X65/schematic/protoC/protoC.pdf

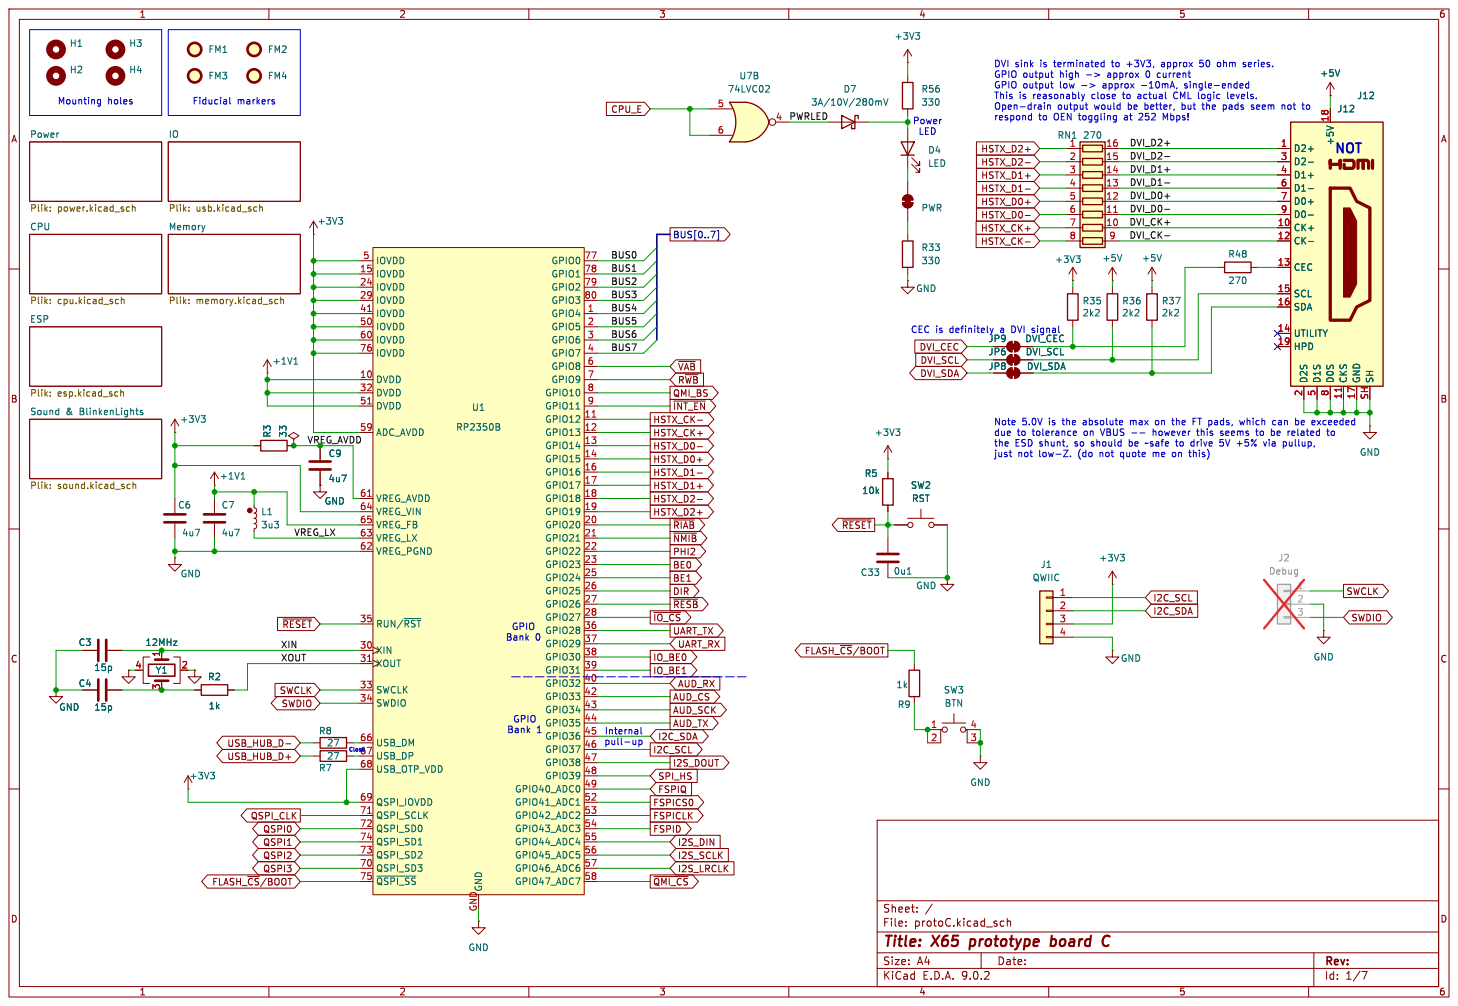
[picture p1: page 1]

J12 D2+ 1 D2- 3 D1+ 4 D1- 6 D0+ 7 D0- 9 CK+ 10 CK- 12 CEC 13 SCL 15 SDA 16 UTILITY 14 HPD 19 D2S

8 CKS 11 GND 17 SH SH

the ESD shunt, so should be ~safe to drive 5V +5% via pullup,
1k SW2 RST

File: protoC.kicad_sch Sheet: /
Id: 1/7 Title: X65 prototype board C

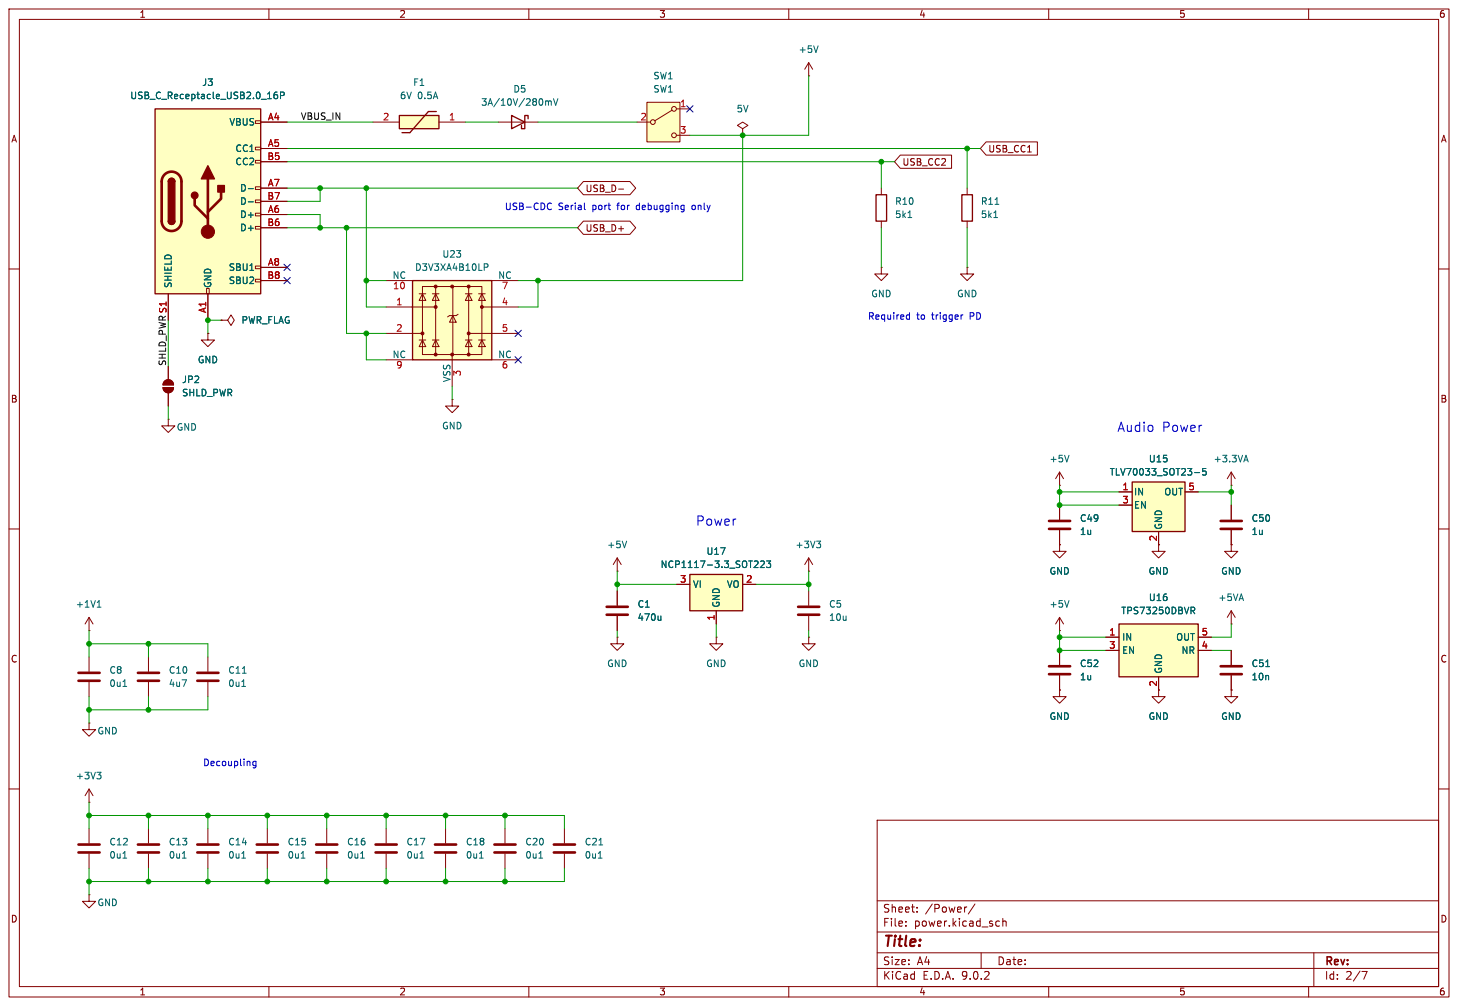
[picture p2: page 2]

Id: 2/7 Title: File: power.kicad_sch Sheet: /Power/

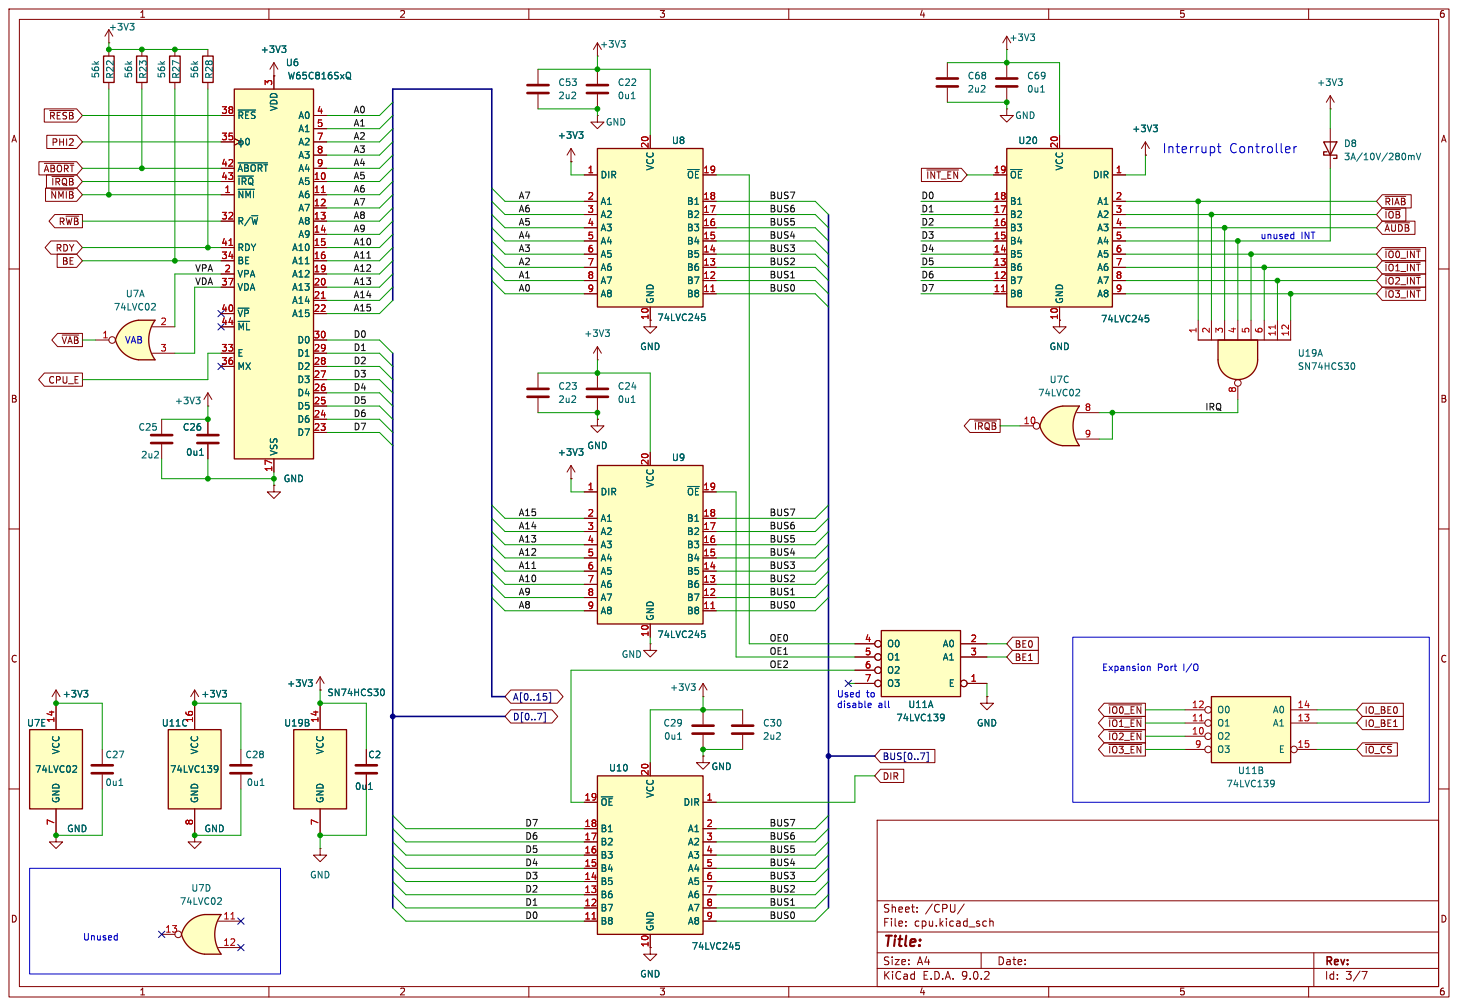
[picture p3: page 3]

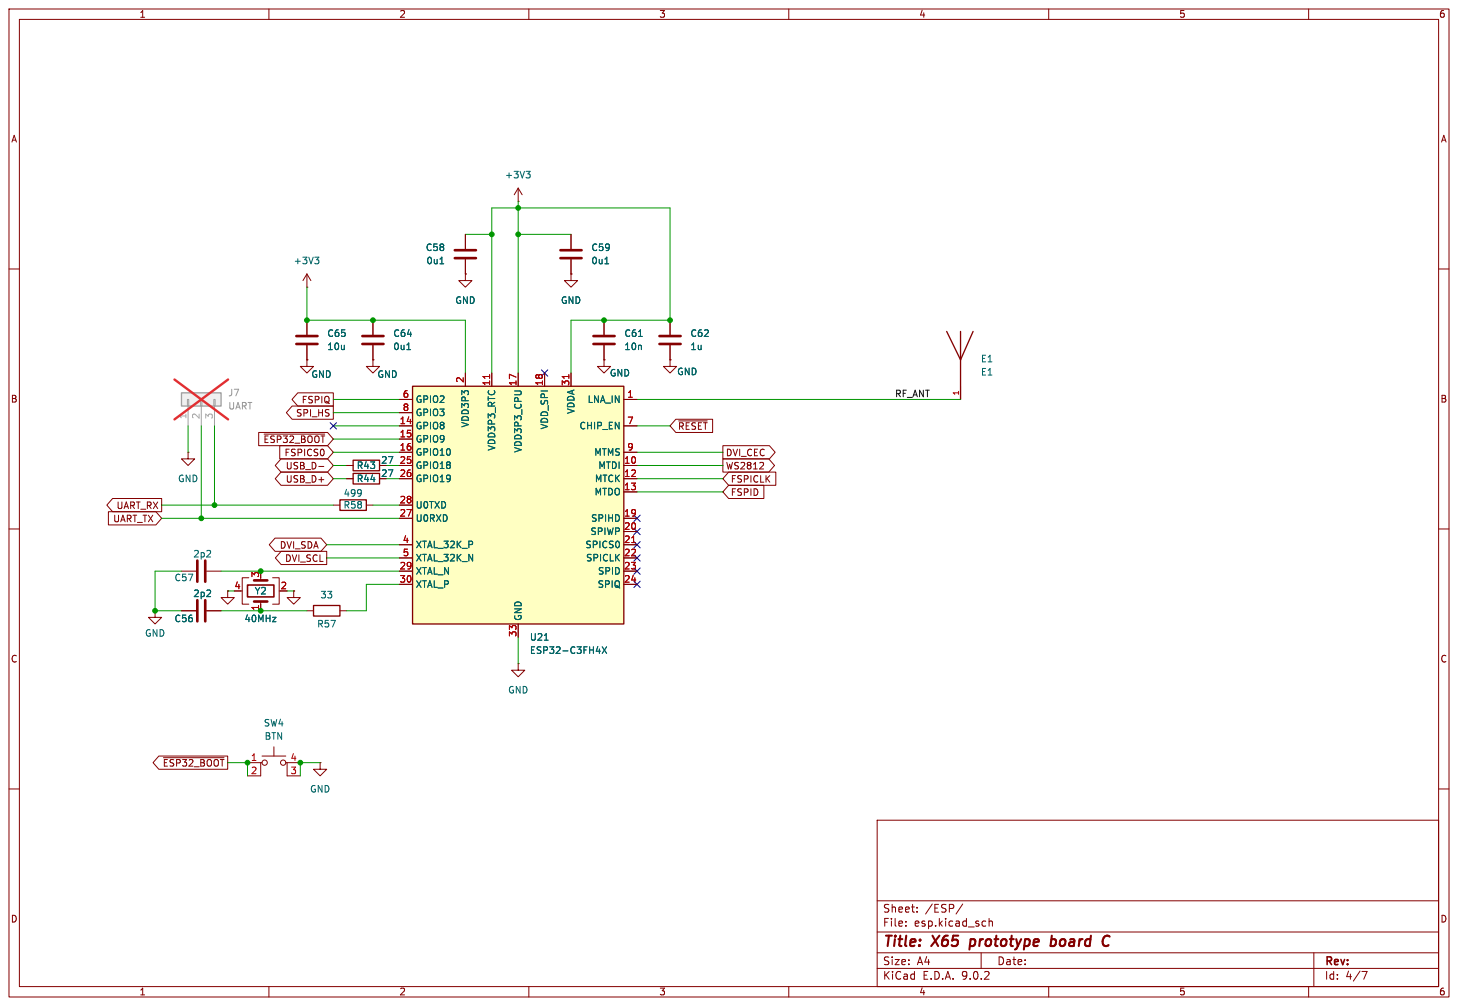
[picture p4: page 4]

File: esp.kicad_sch Sheet: /ESP/
Id: 4/7 Title: X65 prototype board C

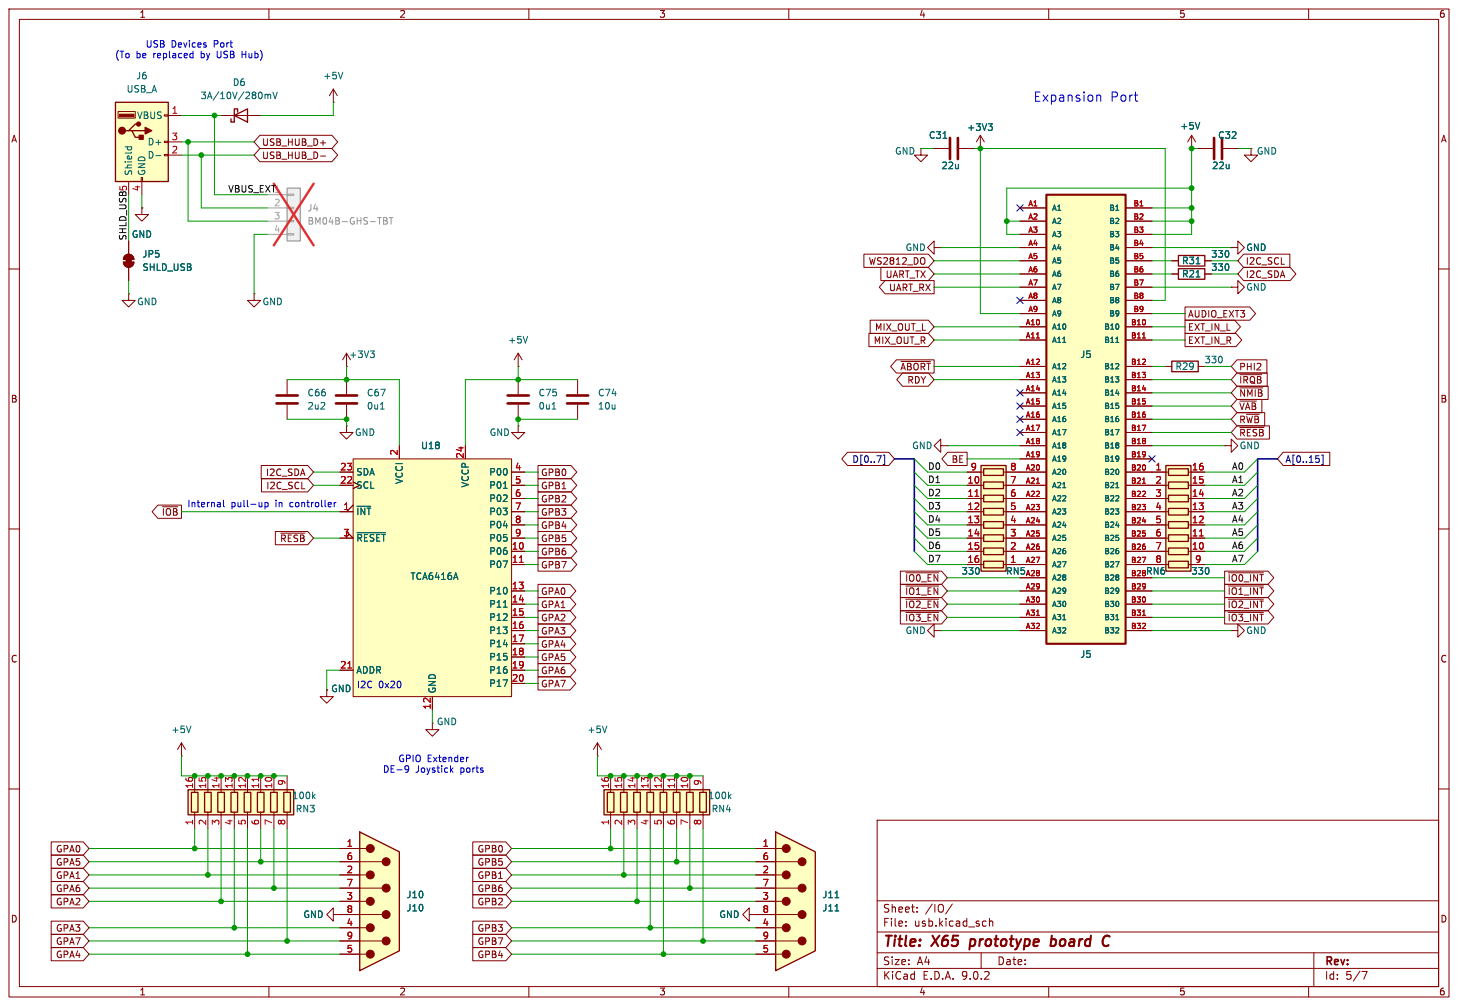
[picture p5: page 5]

File: usb.kicad_sch Sheet: /IO/ GND GND GND

Id: 5/7 Title: X65 prototype board C

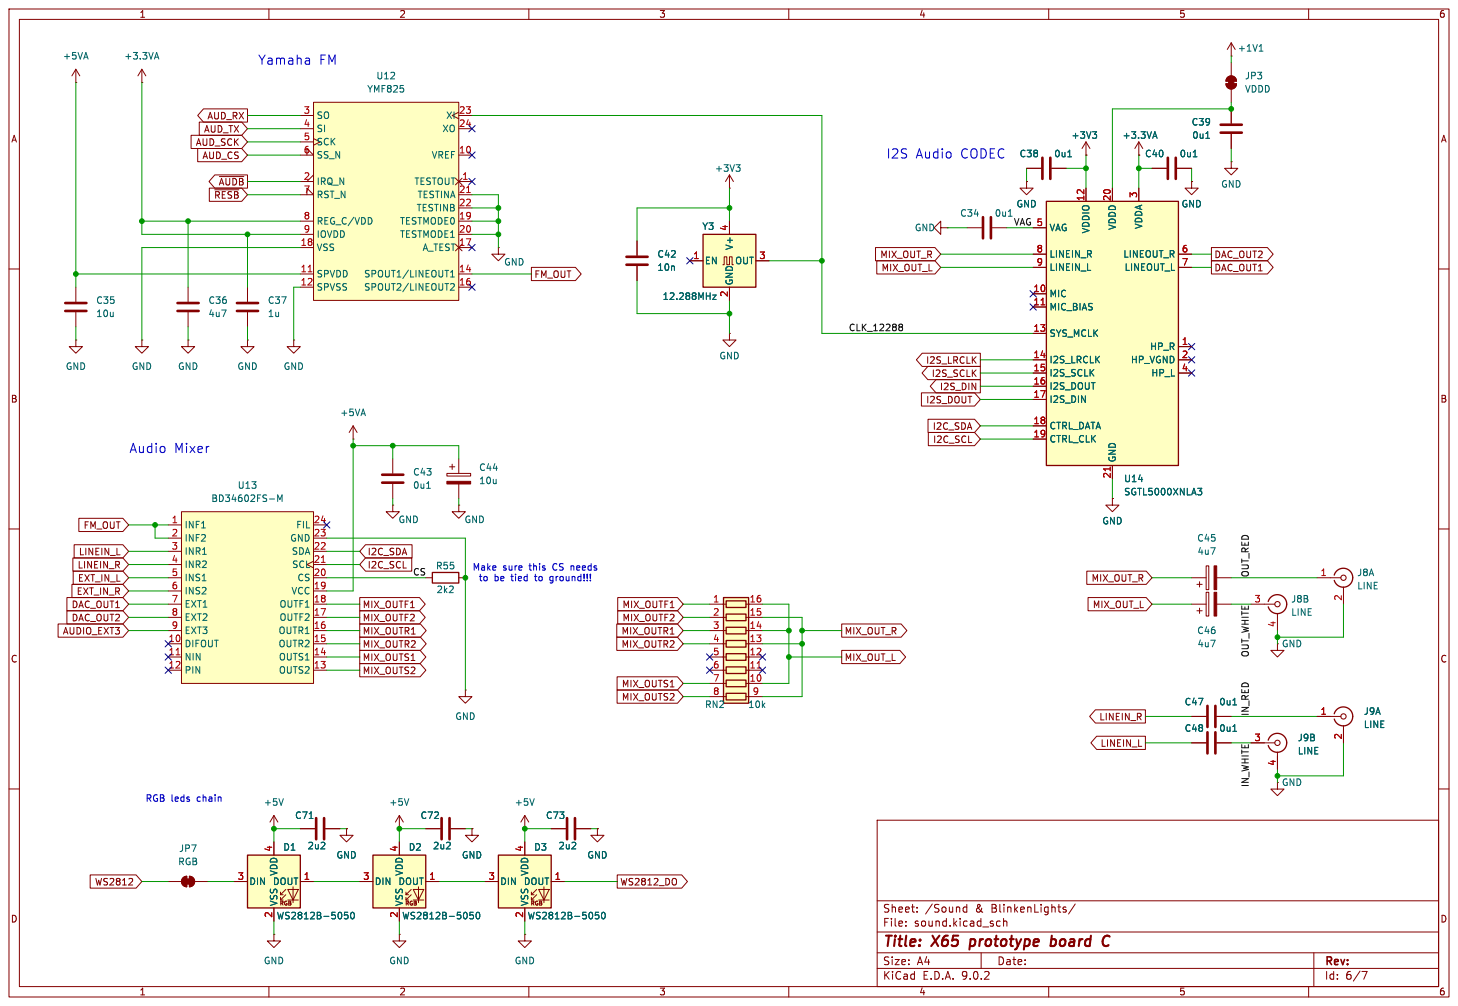
[picture p6: page 6]

Make sure this CS needs
to be tied to ground!!!

2 DOUT 1 D3 WS2812B-5050 GND GND GND

Id: 6/7 Title: X65 prototype board C

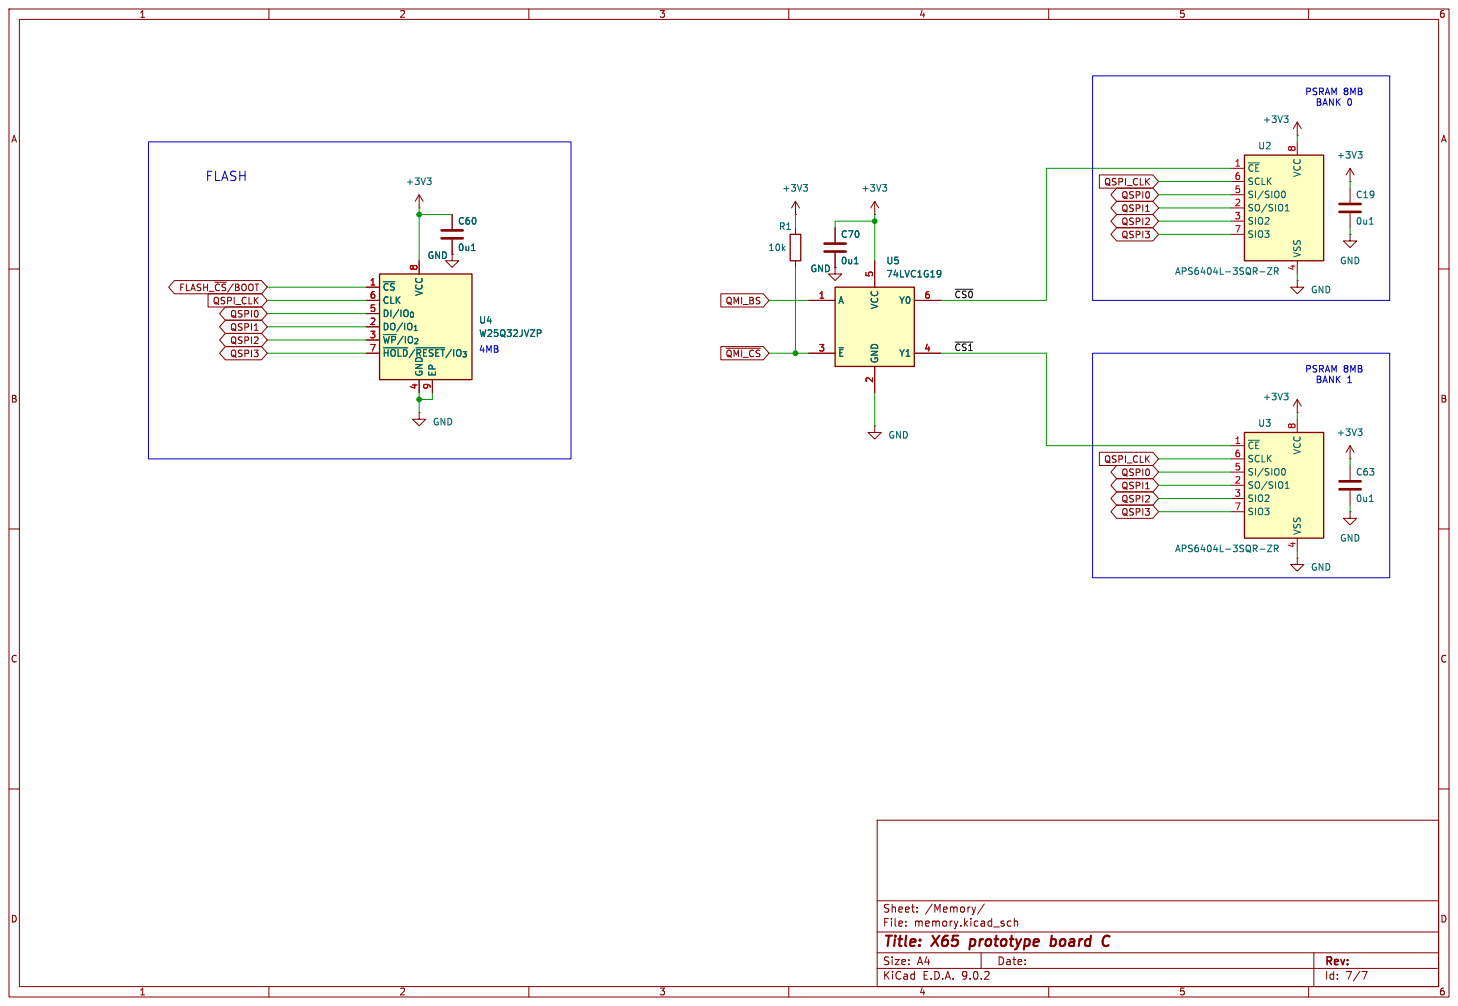
[picture p7: page 7]

4 ~{CE} 1 SCLK 6 SI/SIO0 5 SO/SIO1 2 SIO2 3 SIO3 7 U2 APS6404L-3SQR-ZR GND

4 ~{CE} 1 SCLK 6 SI/SIO0 5 SO/SIO1 2 SIO2 3 SIO3 7 U3 APS6404L-3SQR-ZR

File: memory.kicad_sch Sheet: /Memory/
Id: 7/7 Title: X65 prototype board C
