X65/schematic/Manufacturing/protoB.1/protoB-B_Fab.pdf

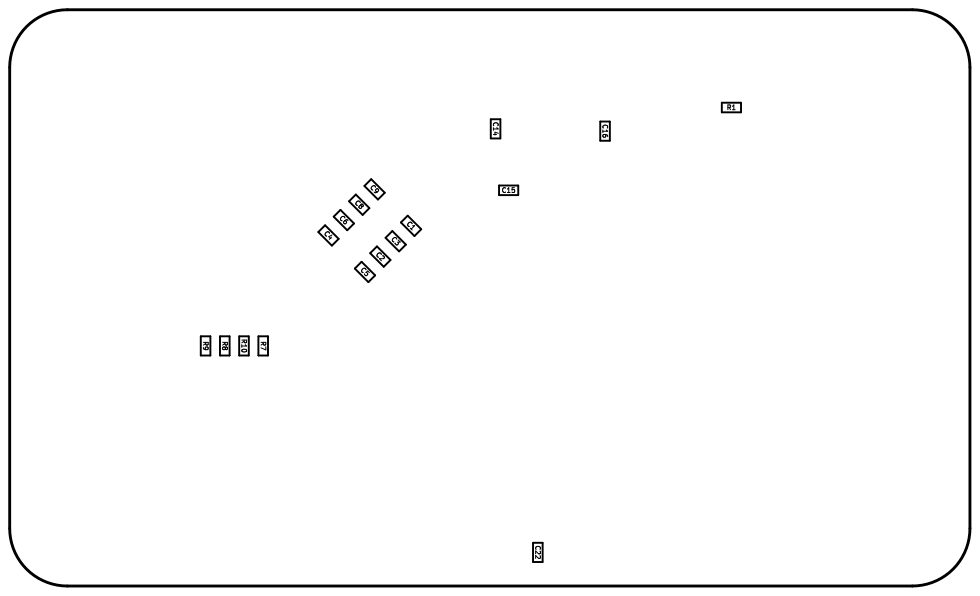
[picture p8: page 1]
