X65/schematic/Manufacturing/protoB.1/protoB-F_Fab.pdf

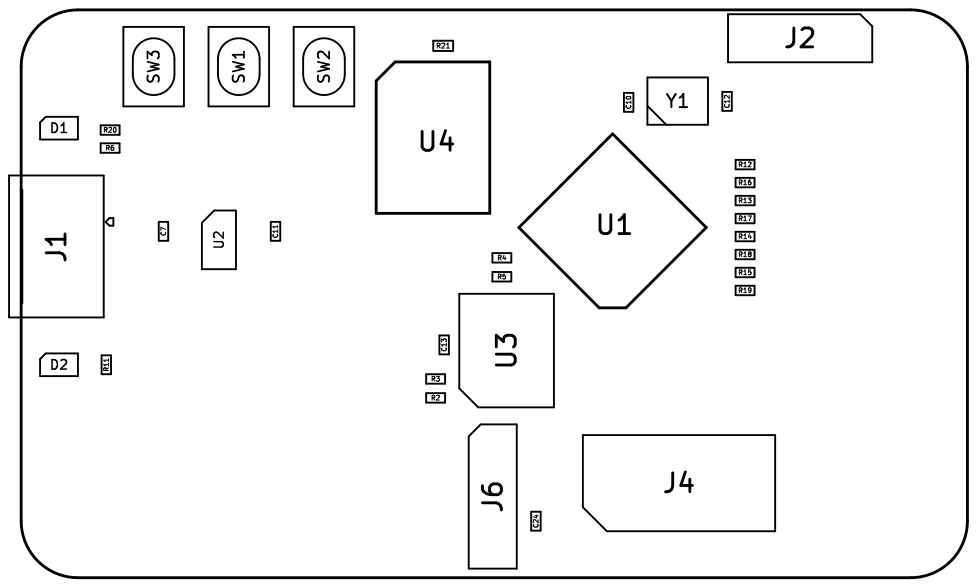
[picture p9: page 1]
