X65/schematic/Manufacturing/protoA.1/protoA-F_Fab.pdf

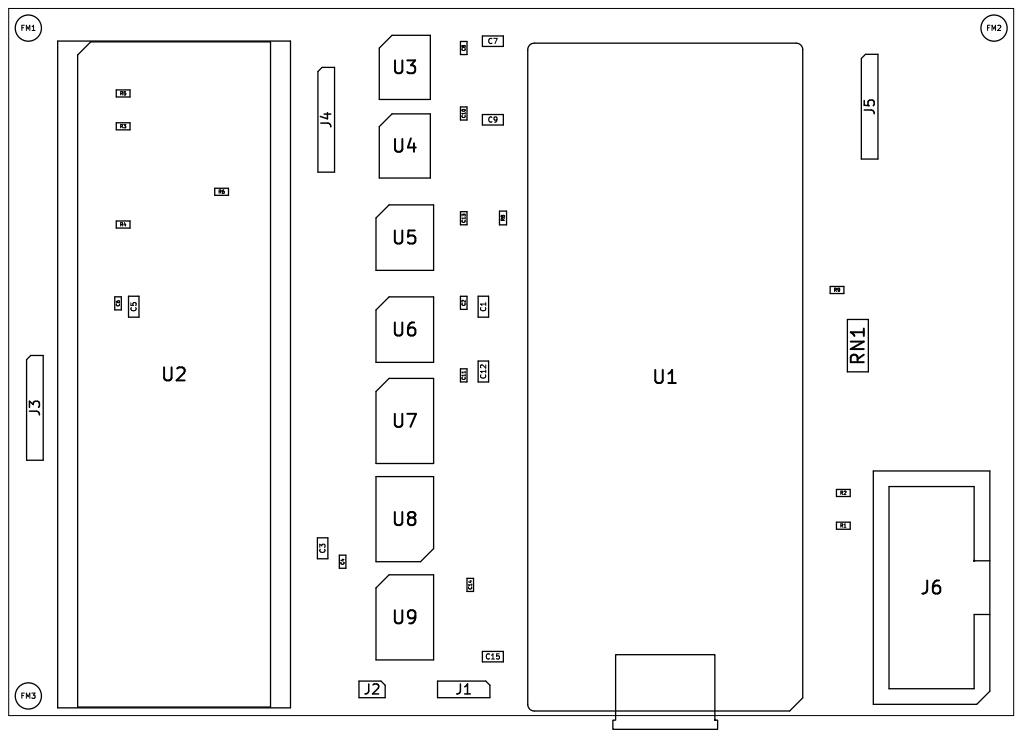
[picture p10: page 1]
