X65/schematic/protoB/protoB.pdf

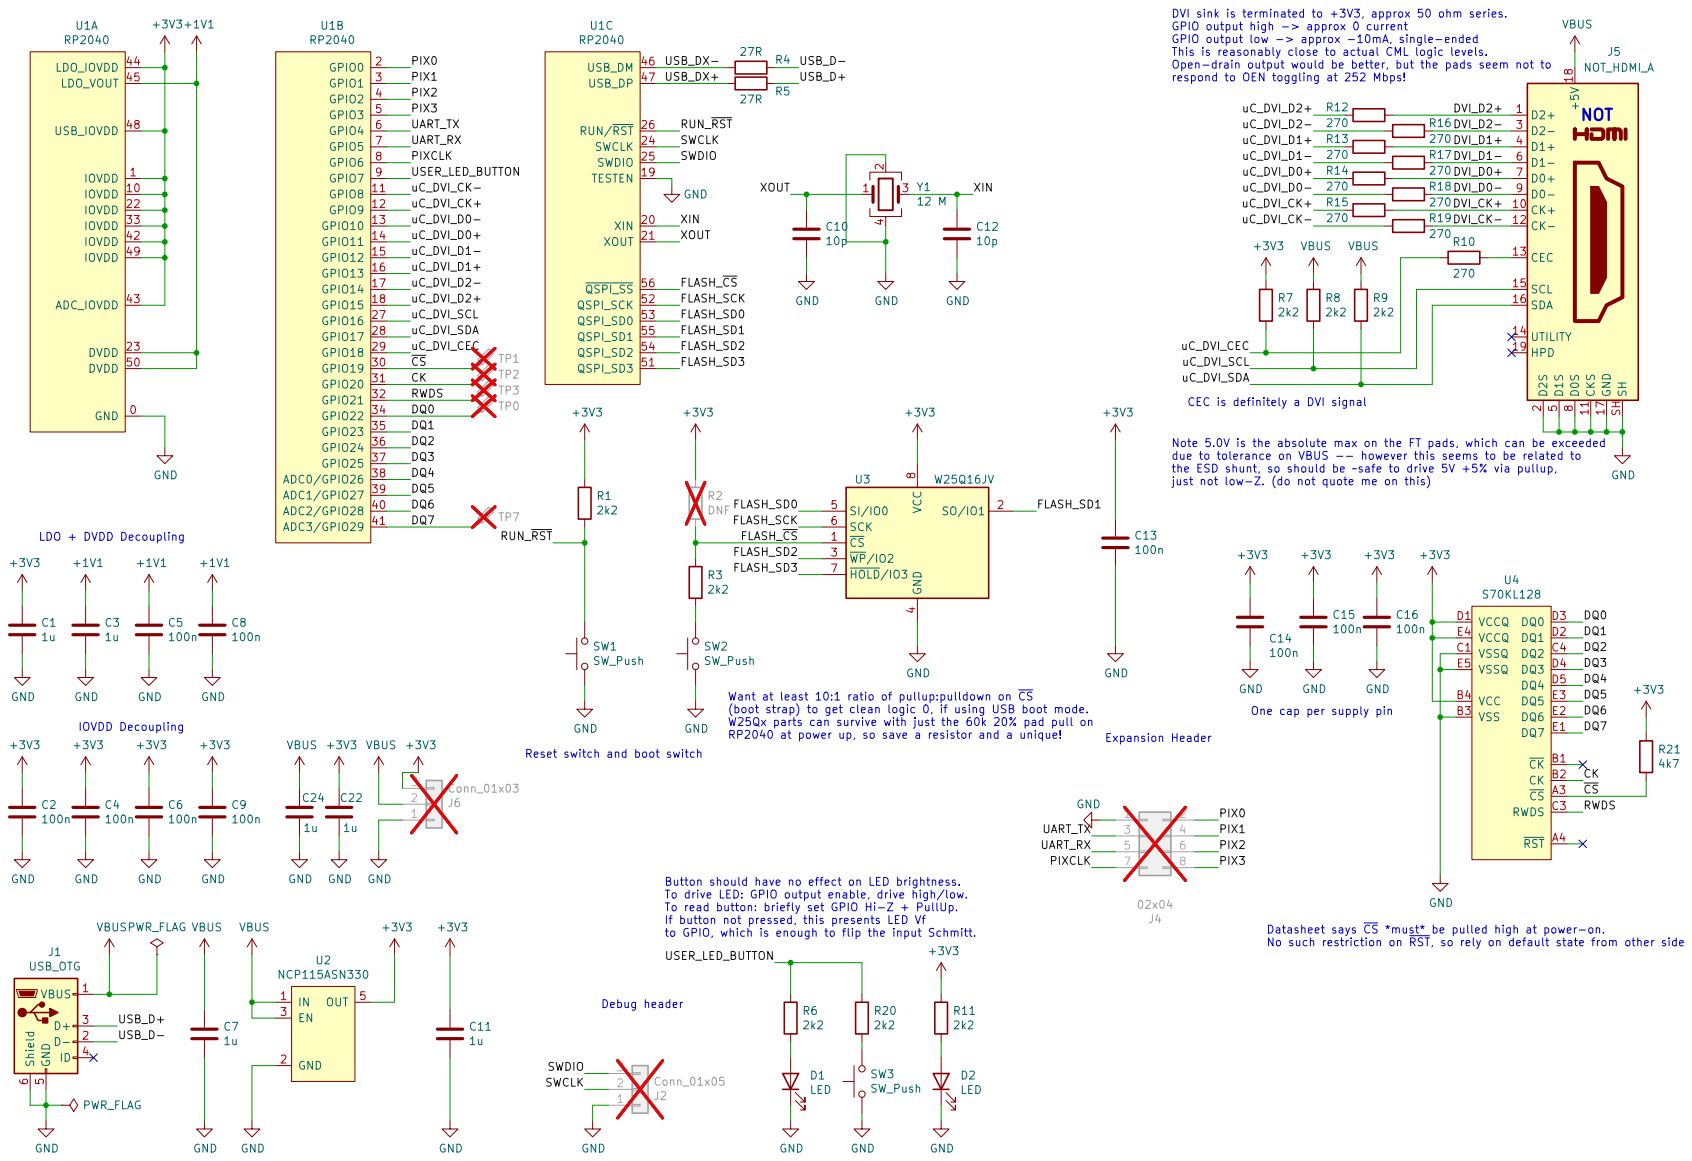
[picture p11: page 1]
