X65/schematic/protoA/protoA.kicad_pcb

## KiCad design protoA/protoA.kicad_pcb (2024-05-02)

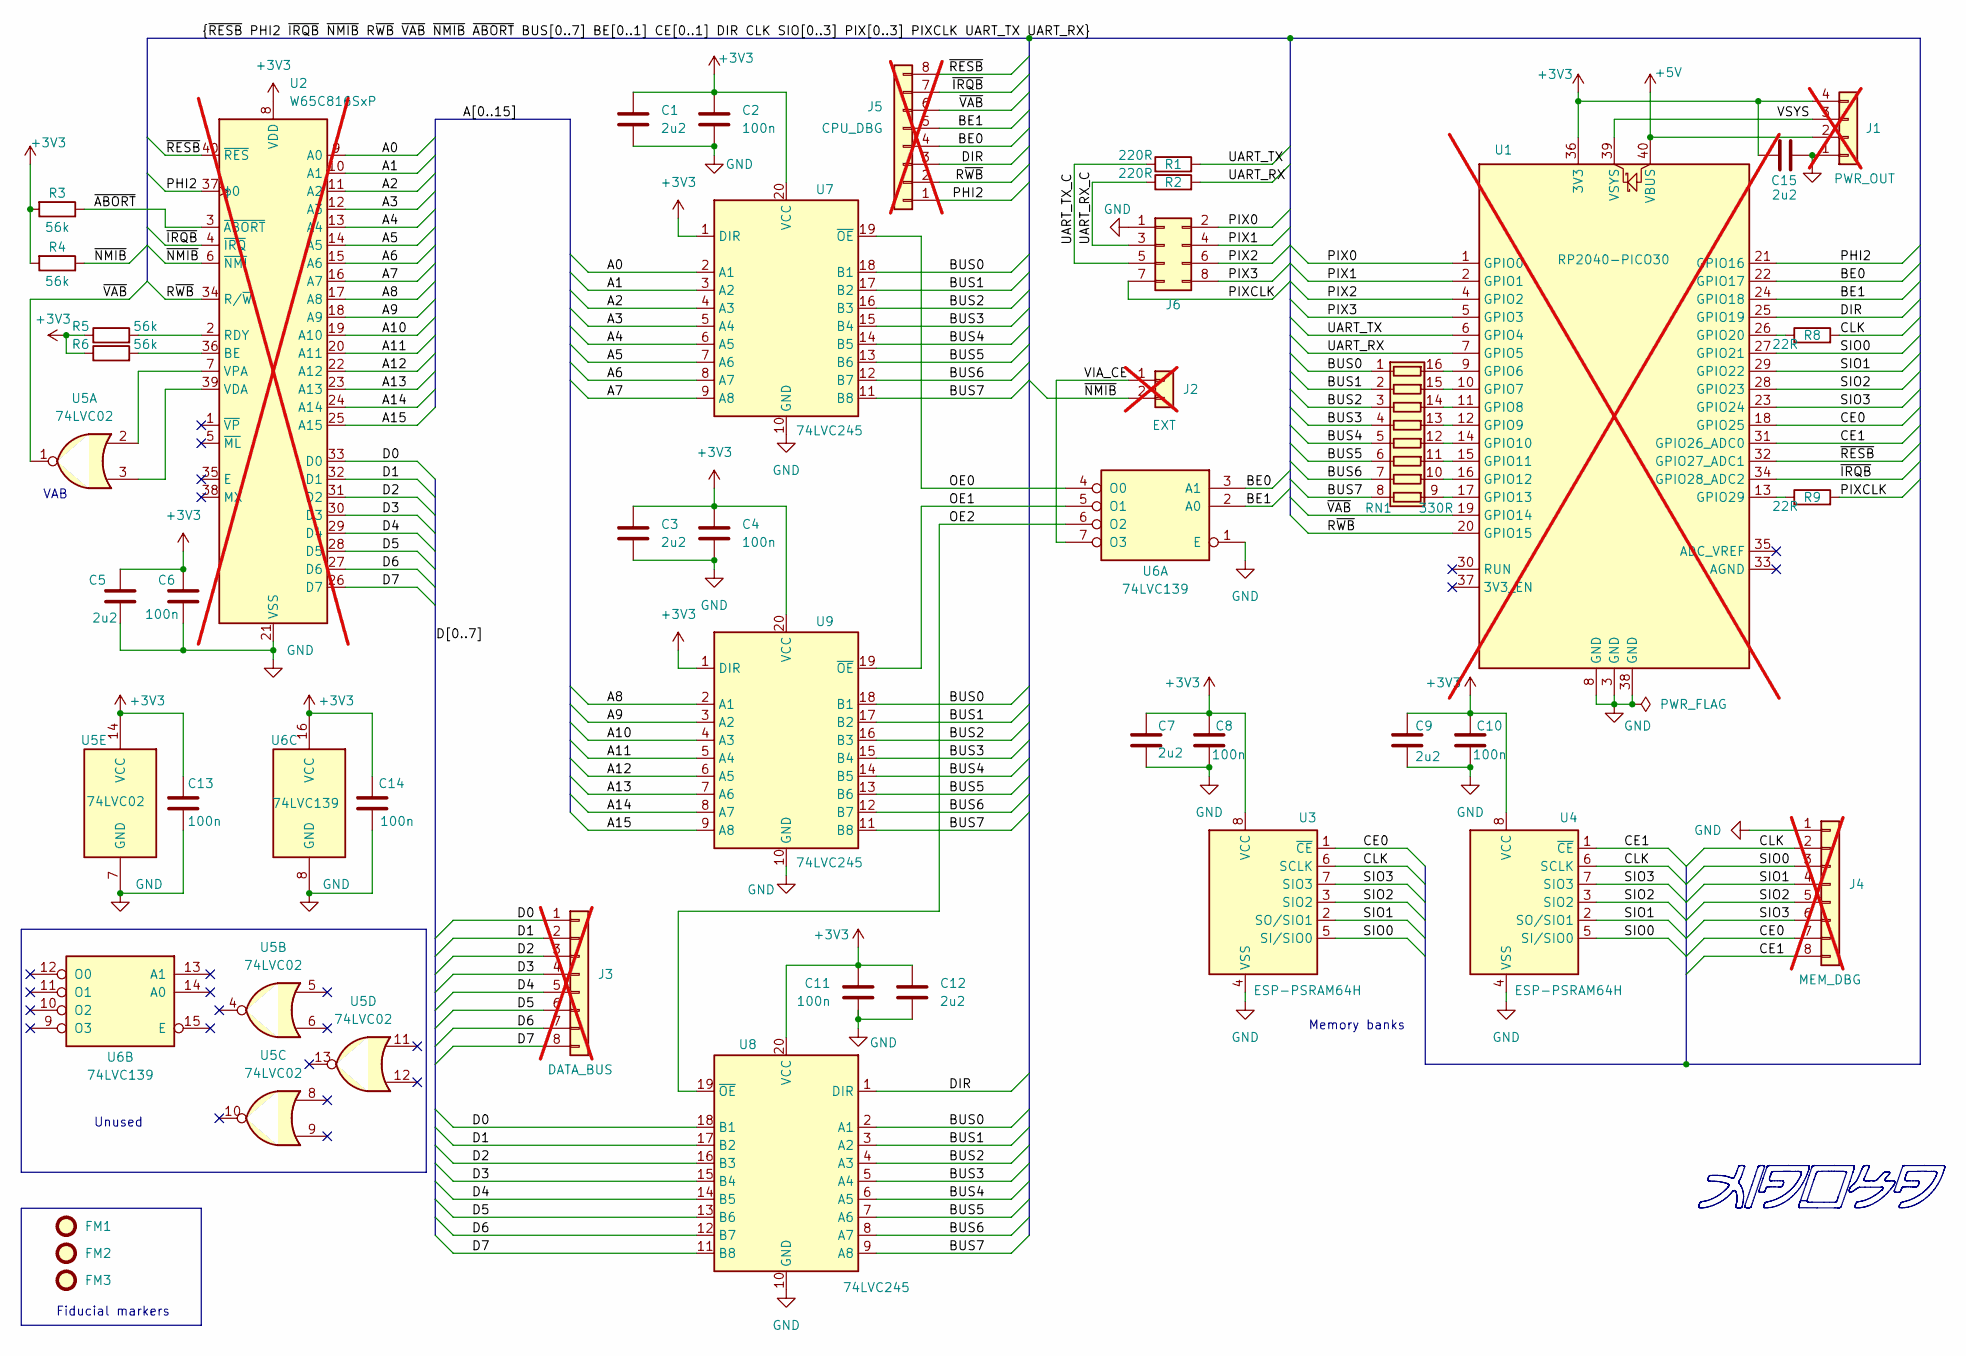
[picture p15: schematic protoA.kicad_sch, X65 proto board A]

Parts:
C1, C3, C5, C7, C9, C12, C15: 2u2; C_0603_1608Metric; Manufacturer Part Number CL10A225KP8NNNC
C2, C4, C6, C8, C10, C11, C13, C14: 100n; C_0402_1005Metric; Manufacturer Part Number CL05B104KO5VPNC
FM1, FM2, FM3: Fiducial; Fiducial_1mm_Mask2mm
J1: PWR_OUT; PinHeader_1x04_P1.00mm_Vertical; not fitted
J2: EXT; PinHeader_1x02_P1.00mm_Vertical; not fitted
J3: DATA_BUS; PinHeader_1x08_P1.00mm_Vertical; not fitted
J4: MEM_DBG; PinHeader_1x08_P1.00mm_Vertical; not fitted
J5: CPU_DBG; PinHeader_1x08_P1.00mm_Vertical; not fitted
J6: PIX; IDC-Header_2x04_P2.54mm_Vertical; Manufacturer Part Number 70246-0801
R1, R2: 220R; R_0402_1005Metric; Manufacturer Part Number ERJ-2GEJ221X
R3, R4, R5, R6: 56k; R_0402_1005Metric; Manufacturer Part Number ERJ-2GEJ563X
R8, R9: 22R; R_0402_1005Metric; Manufacturer Part Number ERJ-2RKF22R0X
RN1: 330R; R_Array_Convex_8x0602; Manufacturer Part Number EXB-2HV331JV
U1: RP2040-PICO30; RaspberryPi_Pico_Common; not fitted
U2: W65C816SxP; DIP-40_W15.24mm_Socket; Manufacturer Part Number W65C816S6PG-14; not fitted
U3, U4: ESP-PSRAM64H; SOIC-8_3.9x4.9mm_P1.27mm; Manufacturer Part Number 4677
U5: 74LVC02; TSSOP-14_4.4x5mm_P0.65mm; Manufacturer Part Number SN74LVC02APWR
U6: 74LVC139; TSSOP-16_4.4x5mm_P0.65mm; Manufacturer Part Number SN74LVC139APWR
U7, U8, U9: 74LVC245; TSSOP-20_4.4x6.5mm_P0.65mm; Manufacturer Part Number SN74LVC245APWR

Connections:
+3V3: C1.1, C2.1, C3.1, C4.1, C5.2, C6.1, C7.1, C8.1, C9.1, C10.1, C11.1, C12.1, C13.1, C14.1, C15.1, J1.4, R3.2, R4.2, R5.1, R6.1, U1.36 (3V3), U2.8 (VDD), U3.8 (VCC), U4.8 (VCC), U5.14 (VCC), U6.16 (VCC), U7.1 (DIR), U7.20 (VCC), U8.20 (VCC), U9.1 (DIR), U9.20 (VCC)
+5V: J1.2, U1.40 (VBUS)
/A0: U2.9 (A0), U7.2 (A1)
/A1: U2.10 (A1), U7.3 (A2)
/A2: U2.11 (A2), U7.4 (A3)
/A3: U2.12 (A3), U7.5 (A4)
/A4: U2.13 (A4), U7.6 (A5)
/A5: U2.14 (A5), U7.7 (A6)
/A6: U2.15 (A6), U7.8 (A7)
/A7: U2.16 (A7), U7.9 (A8)
/A8: U2.17 (A8), U9.2 (A1)
/A9: U2.18 (A9), U9.3 (A2)
/A10: U2.19 (A10), U9.4 (A3)
/A11: U2.20 (A11), U9.5 (A4)
/A12: U2.22 (A12), U9.6 (A5)
/A13: U2.23 (A13), U9.7 (A6)
/A14: U2.24 (A14), U9.8 (A7)
/A15: U2.25 (A15), U9.9 (A8)
/BE0: J5.4, U1.22 (GPIO17), U6.3 (A1)
/BE1: J5.5, U1.24 (GPIO18), U6.2 (A0)
/BUS0: RN1.1 (R1.1), U7.18 (B1), U8.2 (A1), U9.18 (B1)
/BUS1: RN1.2 (R2.1), U7.17 (B2), U8.3 (A2), U9.17 (B2)
/BUS2: RN1.3 (R3.1), U7.16 (B3), U8.4 (A3), U9.16 (B3)
/BUS3: RN1.4 (R4.1), U7.15 (B4), U8.5 (A4), U9.15 (B4)
/BUS4: RN1.5 (R5.1), U7.14 (B5), U8.6 (A5), U9.14 (B5)
/BUS5: RN1.6 (R6.1), U7.13 (B6), U8.7 (A6), U9.13 (B6)
/BUS6: RN1.7 (R7.1), U7.12 (B7), U8.8 (A7), U9.12 (B7)
/BUS7: RN1.8 (R8.1), U7.11 (B8), U8.9 (A8), U9.11 (B8)
/CE0: J4.7, U1.18 (GPIO25), U3.1 (~CE)
/CE1: J4.8, U1.31 (GPIO26_ADC0), U4.1 (~CE)
/CLK: J4.2, R8.2, U3.6 (SCLK), U4.6 (SCLK)
/D0: J3.1, U2.33 (D0), U8.18 (B1)
/D1: J3.2, U2.32 (D1), U8.17 (B2)
/D2: J3.3, U2.31 (D2), U8.16 (B3)
/D3: J3.4, U2.30 (D3), U8.15 (B4)
/D4: J3.5, U2.29 (D4), U8.14 (B5)
/D5: J3.6, U2.28 (D5), U8.13 (B6)
/D6: J3.7, U2.27 (D6), U8.12 (B7)
/D7: J3.8, U2.26 (D7), U8.11 (B8)
/DIR: J5.3, U1.25 (GPIO19), U8.1 (DIR)
/OE0: U6.4 (O0), U7.19 (~OE)
/OE1: U6.5 (O1), U9.19 (~OE)
/OE2: U6.6 (O2), U8.19 (~OE)
/PHI2: J5.1, U1.21 (GPIO16), U2.37 (ϕ0)
/PIX0: J6.2, U1.1 (GPIO0)
/PIX1: J6.4, U1.2 (GPIO1)
/PIX2: J6.6, U1.4 (GPIO2)
/PIX3: J6.8, U1.5 (GPIO3)
/PIXCLK: J6.7, R9.2
/R~WB: J5.2, U1.20 (GPIO15), U2.34 (R/~W)
/SIO0: J4.3, U1.27 (GPIO21), U3.5 (SI/SIO0), U4.5 (SI/SIO0)
/SIO1: J4.4, U1.29 (GPIO22), U3.2 (SO/SIO1), U4.2 (SO/SIO1)
/SIO2: J4.5, U1.28 (GPIO23), U3.3 (SIO2), U4.3 (SIO2)
/SIO3: J4.6, U1.23 (GPIO24), U3.7 (SIO3), U4.7 (SIO3)
/UART_RX: R2.2, U1.7 (GPIO5)
/UART_RX_C: J6.3, R2.1
/UART_TX: R1.2, U1.6 (GPIO4)
/UART_TX_C: J6.5, R1.1
/VIA_CE: J2.1, U6.7 (O3)
/VSYS: J1.3, U1.39 (VSYS)
/~ABORT: R3.1, U2.3 (~ABORT)
/~IRQB: J5.7, U1.34 (GPIO28_ADC2), U2.4 (~IRQ)
/~NMIB: J2.2, R4.1, U2.6 (~NMI)
/~RESB: J5.8, U1.32 (GPIO27_ADC1), U2.40 (~RES)
/~VAB: J5.6, U1.19 (GPIO14), U5.1
GND: C1.2, C2.2, C3.2, C4.2, C5.1, C6.2, C7.2, C8.2, C9.2, C10.2, C11.2, C12.2, C13.2, C14.2, C15.2, J1.1, J4.1, J6.1, U1.3 (GND), U1.8 (GND), U1.38 (GND), U2.21 (VSS), U3.4 (VSS), U4.4 (VSS), U5.7 (GND), U6.1 (E), U6.8 (GND), U7.10 (GND), U8.10 (GND), U9.10 (GND)
unnamed: RN1.16 (R1.2), U1.9 (GPIO6)
unnamed: RN1.15 (R2.2), U1.10 (GPIO7)
unnamed: RN1.14 (R3.2), U1.11 (GPIO8)
unnamed: RN1.13 (R4.2), U1.12 (GPIO9)
unnamed: RN1.12 (R5.2), U1.14 (GPIO10)
unnamed: RN1.11 (R6.2), U1.15 (GPIO11)
unnamed: RN1.10 (R7.2), U1.16 (GPIO12)
unnamed: RN1.9 (R8.2), U1.17 (GPIO13)
unnamed: R8.1, U1.26 (GPIO20)
unnamed: R9.1, U1.13 (GPIO29)
unnamed: R6.2, U2.36 (BE)
unnamed: R5.2, U2.2 (RDY)
unnamed: U2.39 (VDA), U5.3
unnamed: U2.7 (VPA), U5.2

Notes on the sheet:
Fiducial markers
Unused
VAB
Memory banks

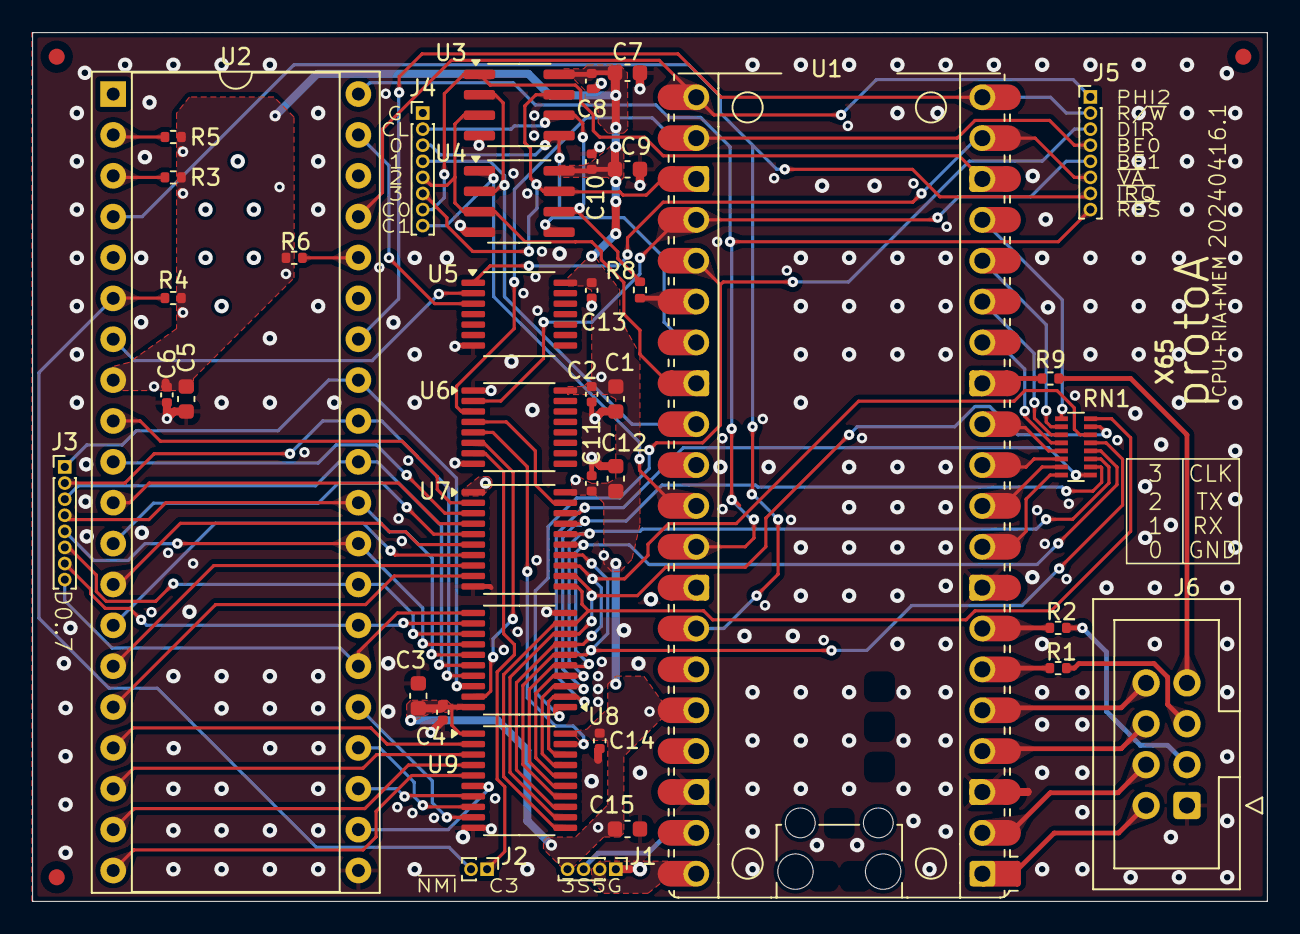
[picture p16: board protoA.kicad_pcb from above]

Board: 4 copper layers, 76.8 x 54.0 mm, 42 parts (0 on the bottom side), 80 nets.
