X65/schematic/(commit log)

2024-03-13 Import https://gitlab.com/recursivenomad/ki-lime-pi-pico
2024-03-13 Schematics of protoA board
    [protoA.kicad_pcb, protoA.kicad_sch]
2024-04-11 protoA ERC Pass
    [protoA.kicad_sch]
2024-04-11 protoA footprints and BOM
2024-04-16 protoA PCB done
    [protoA.kicad_pcb, protoA.kicad_sch]
2024-04-17 protoA BOM update
    [protoA-BOM.csv, protoA.kicad_pcb, protoA.kicad_sch]
2024-04-17 protoA Manufacturing files
    [protoA-BOM.csv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]
2024-04-17 protoA Fabrication drawing
    [protoA.kicad_pcb]
2024-05-02 Fix J6 PIX connector BOM designator
    [protoA.kicad_pcb, protoA.kicad_sch]
2024-05-26 Add protoB schematic, board and manufacturing
    [protoB-BOM.csv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]
2024-07-16 Add protoB.pdf schematic
2025-05-15 Simplified Interrupt Controller
